bbenchoff/RGB-Gaming-Coaster/README.md

# RGB-Gaming-Coaster
An Oreo construction RGB disc sort of thing

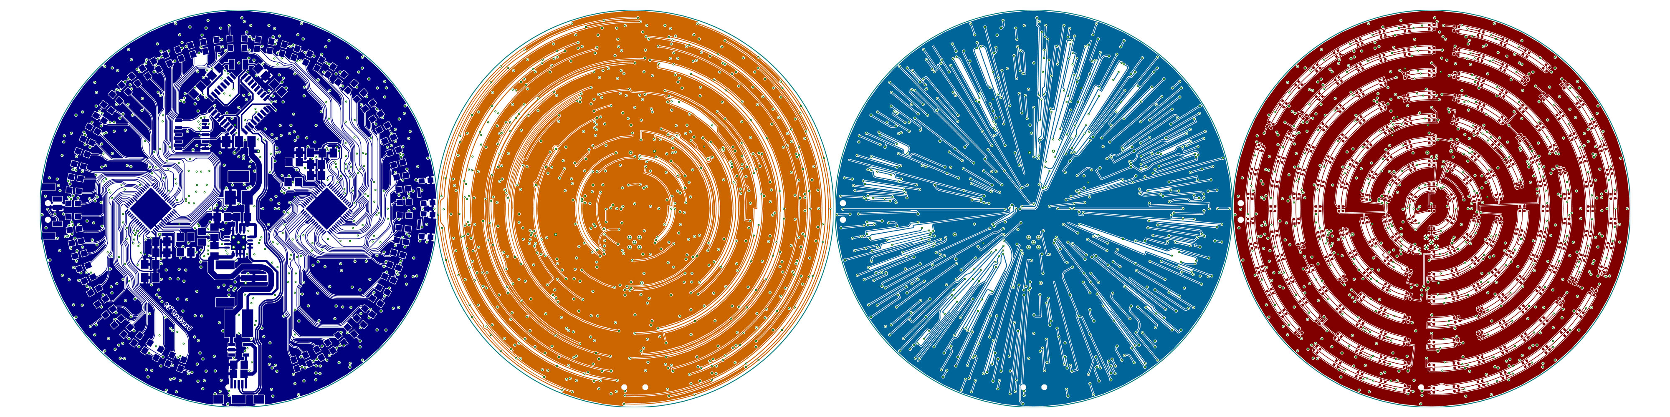
[picture p1: Art/Composite.png]
thing
