bbenchoff/RGB-Gaming-Coaster/Art/1.png

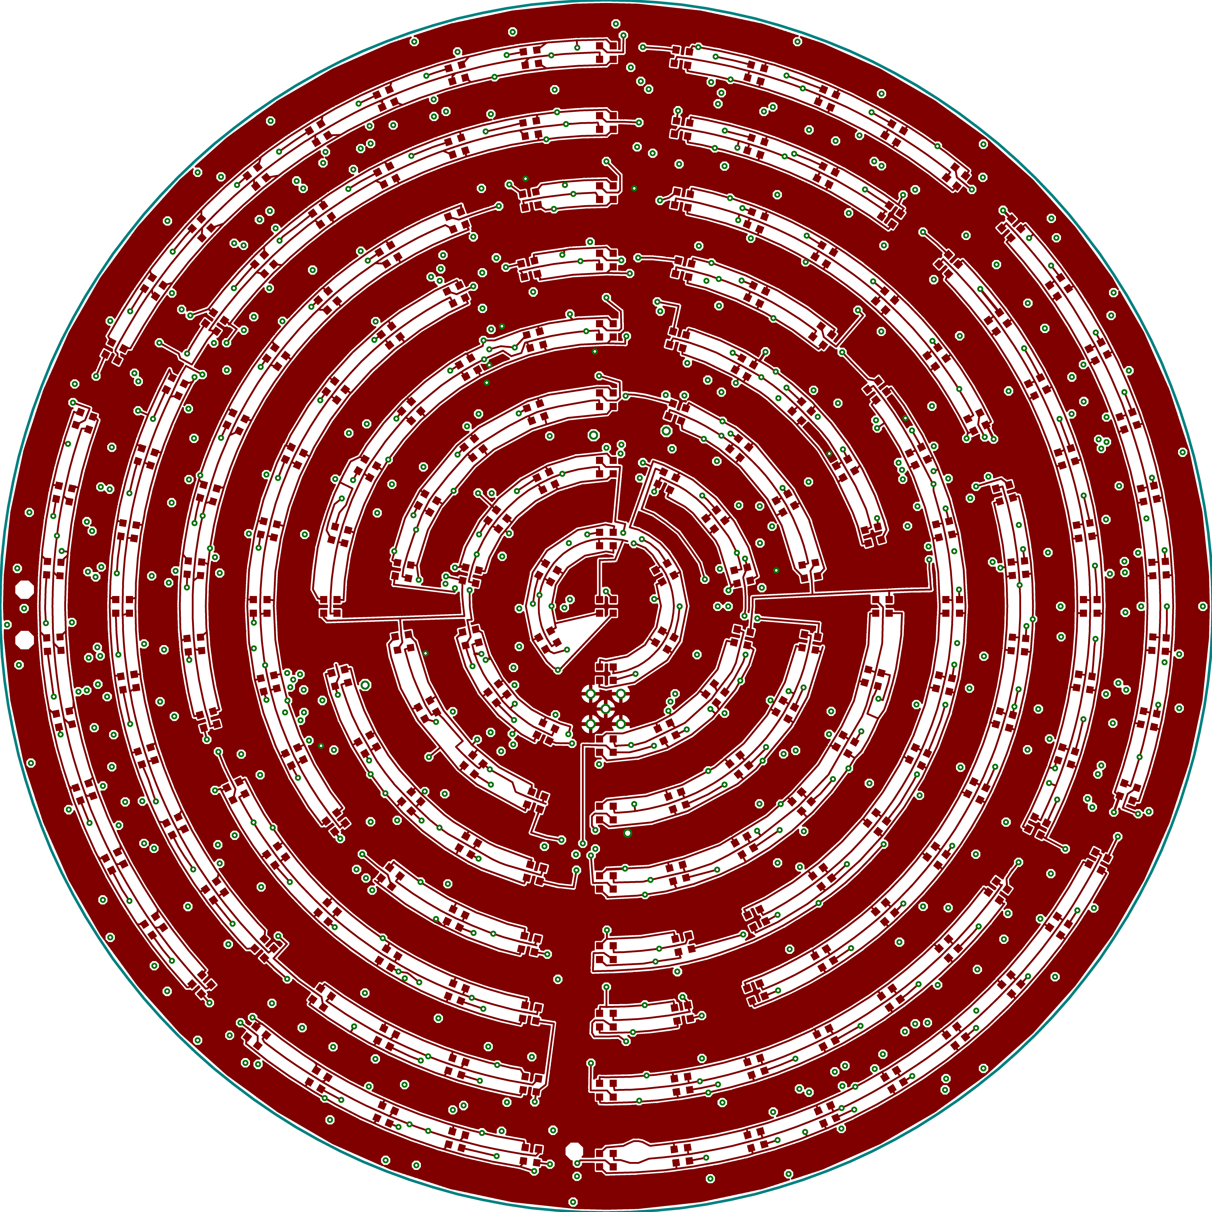
Art/1.png
