bbenchoff/RGB-Gaming-Coaster/Art/2.png

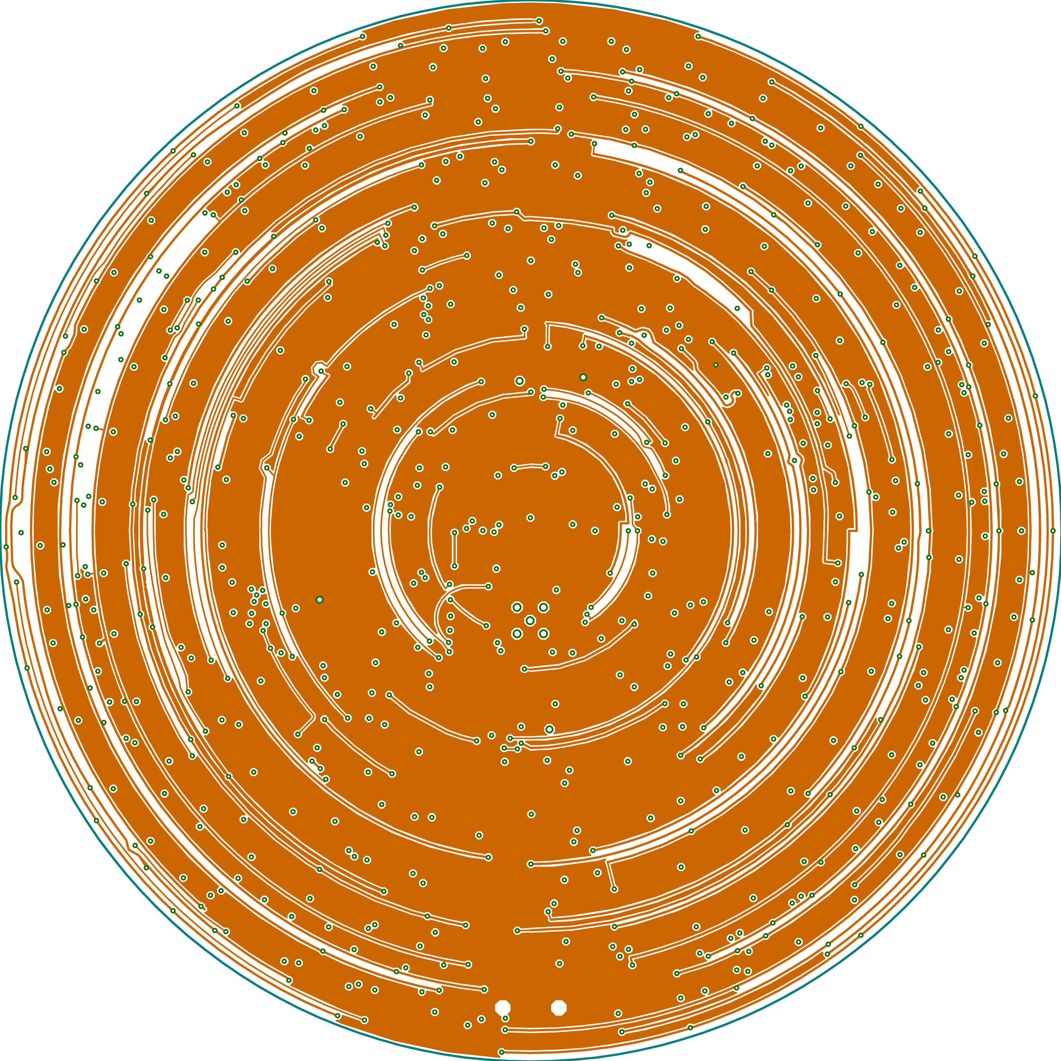
Art/2.png
