bbenchoff/RGB-Gaming-Coaster/Art/15.png

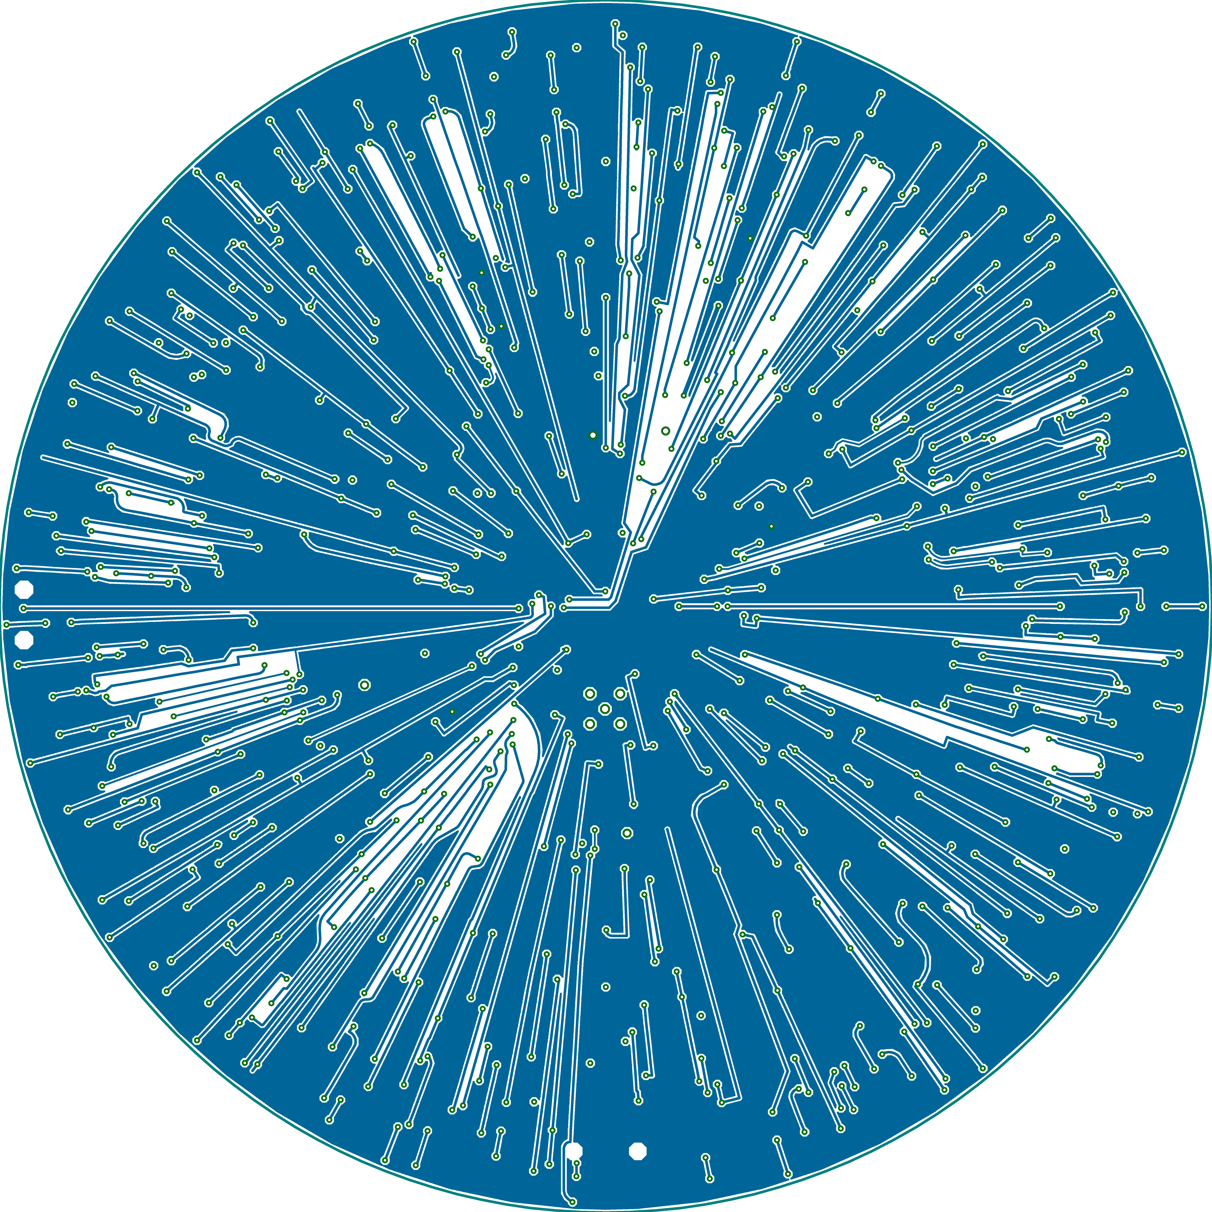
Art/15.png
