bbenchoff/RGB-Gaming-Coaster/Art/16.png

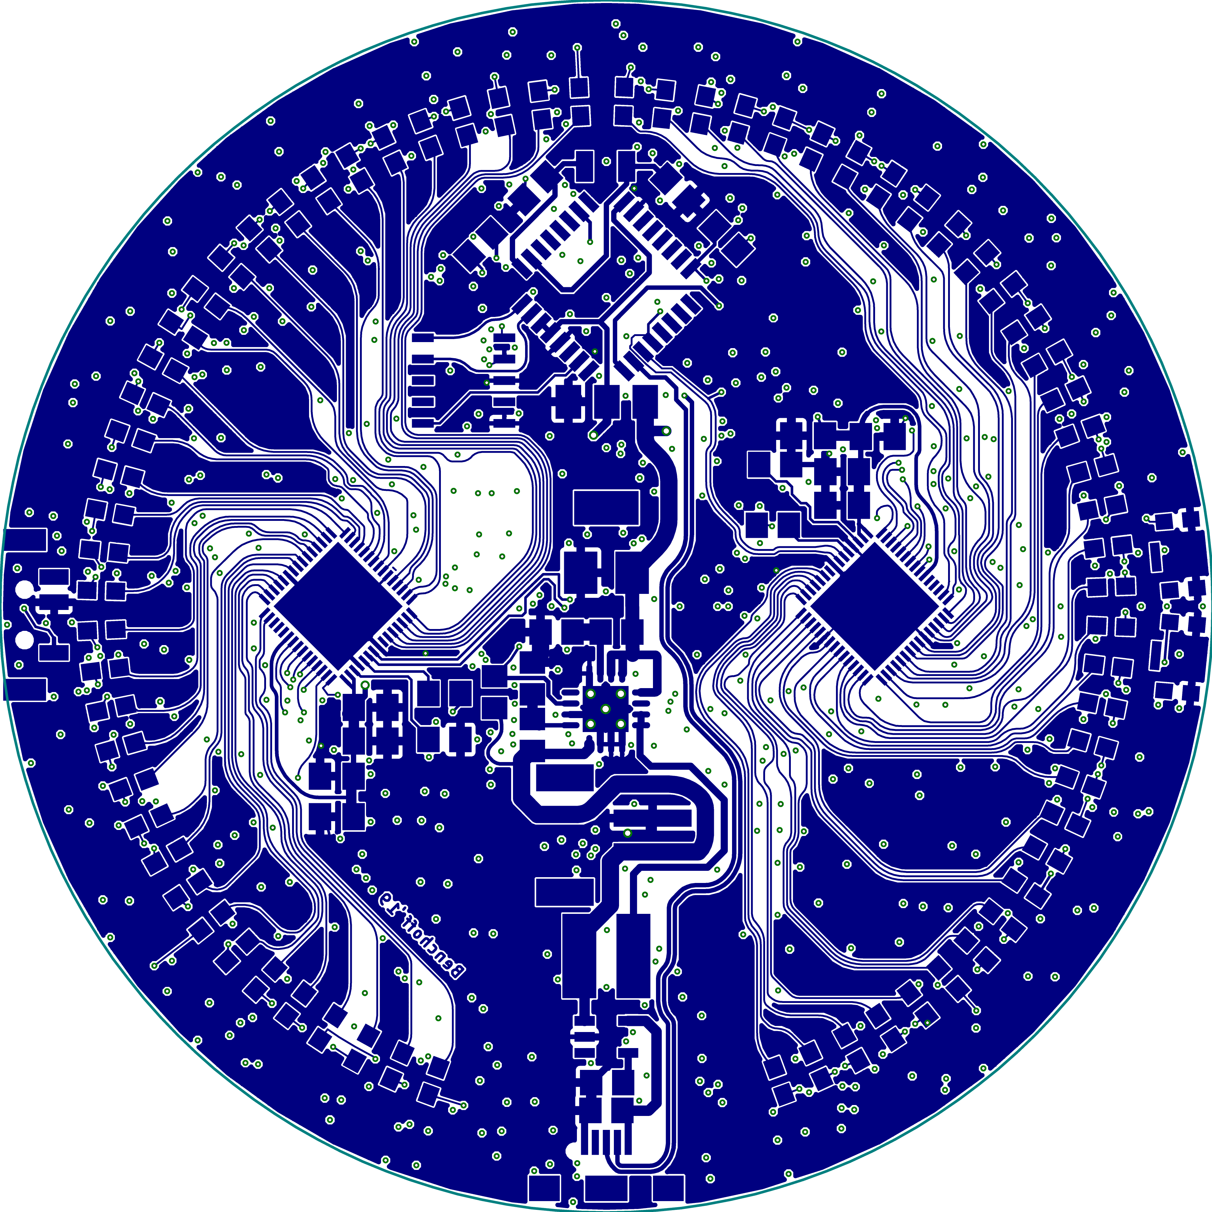
Art/16.png
