bbenchoff/RGB-Gaming-Coaster/Art/Github.bmp

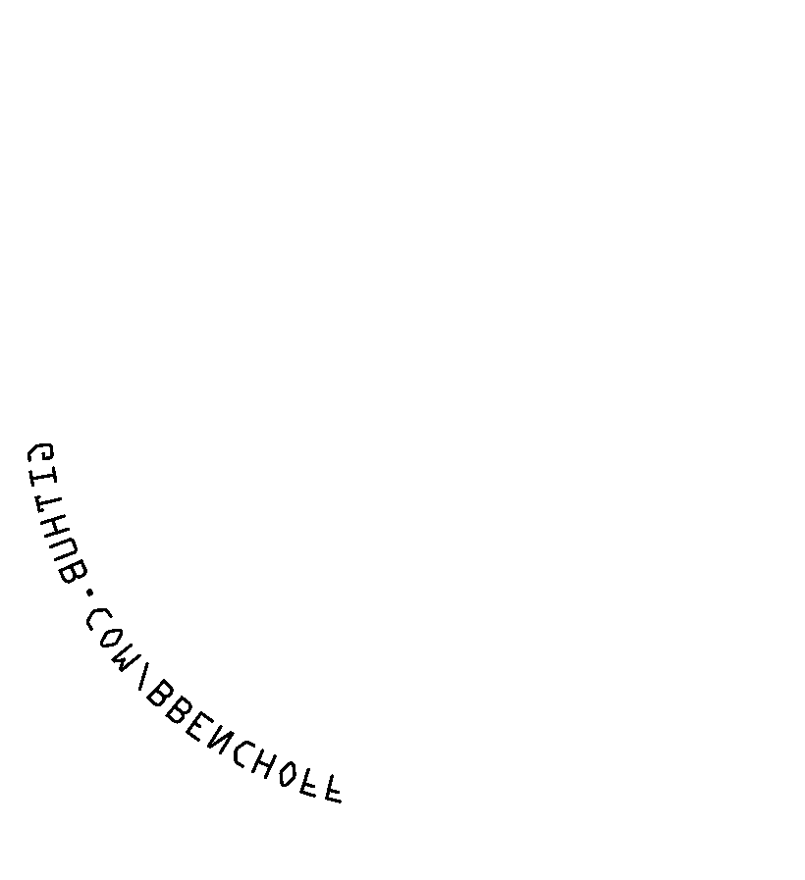
Art/Github.bmp
