bbenchoff/RGB-Gaming-Coaster/Art/Outside Text.bmp

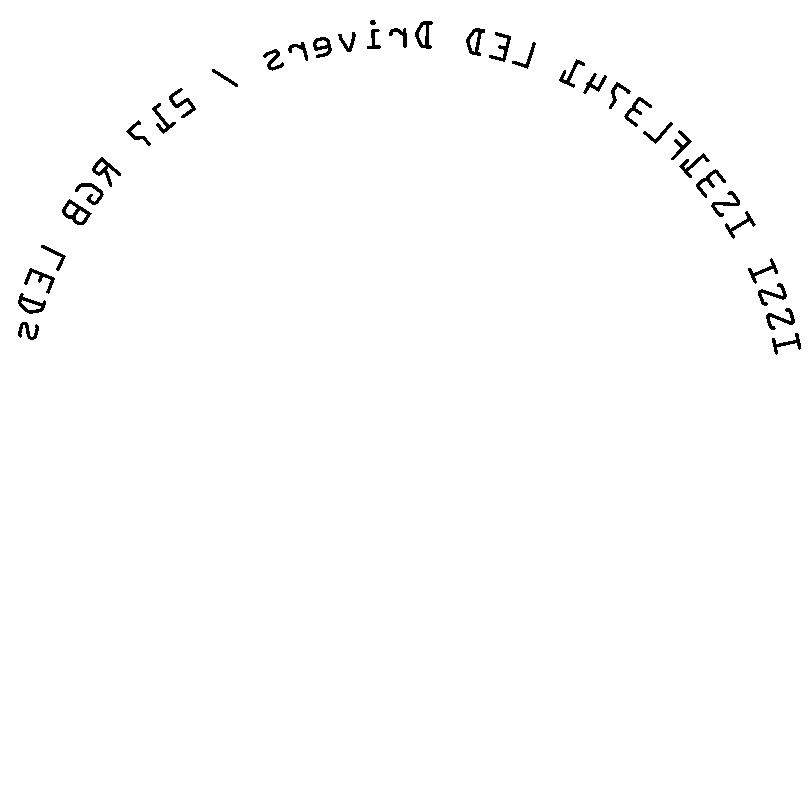
Art/Outside Text.bmp
