bbenchoff/RGB-Gaming-Coaster/Art/RGB Gaming Coaster.bmp

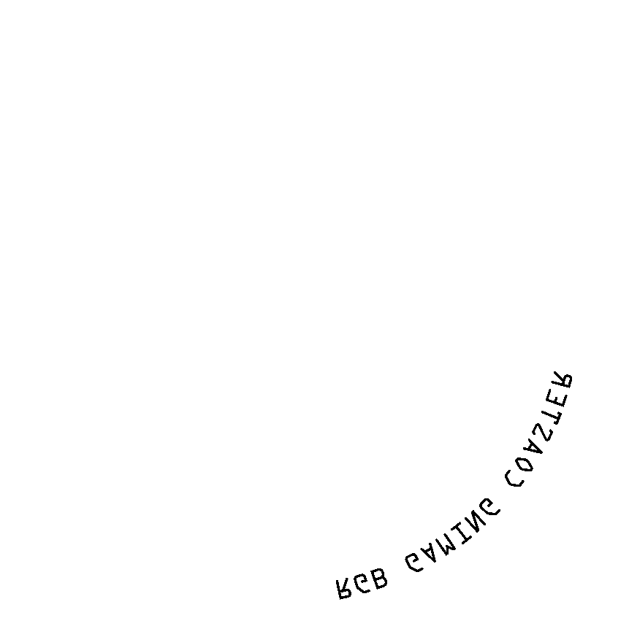
Art/RGB Gaming Coaster.bmp
