bbenchoff/RGB-Gaming-Coaster/Documentation/ring.png

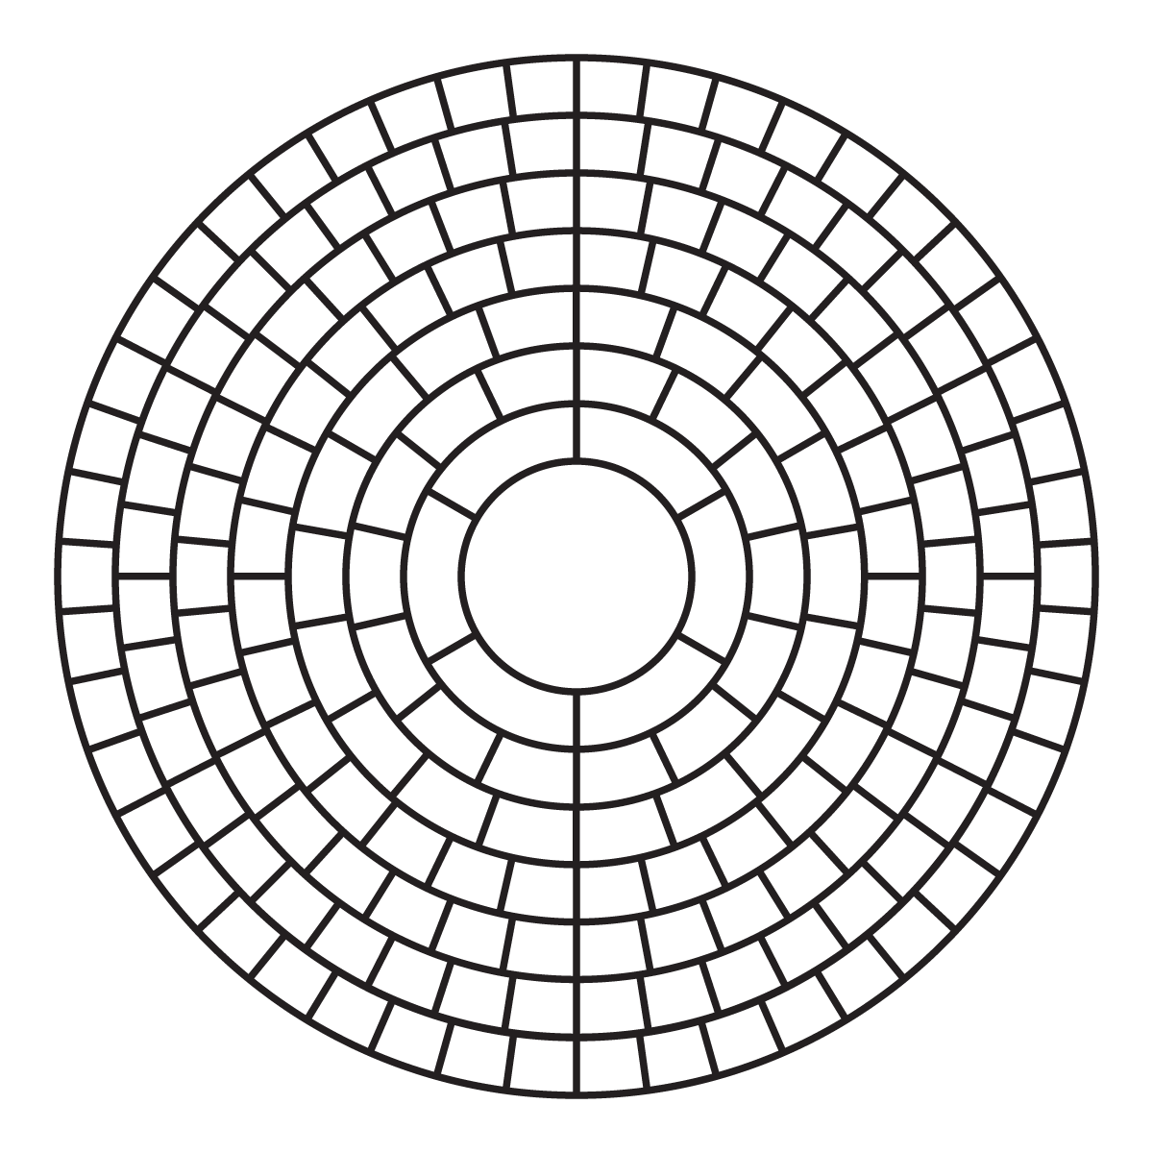
Documentation/ring.png
