bbenchoff/RGB-Gaming-Coaster/Documentation/ringcolors.png

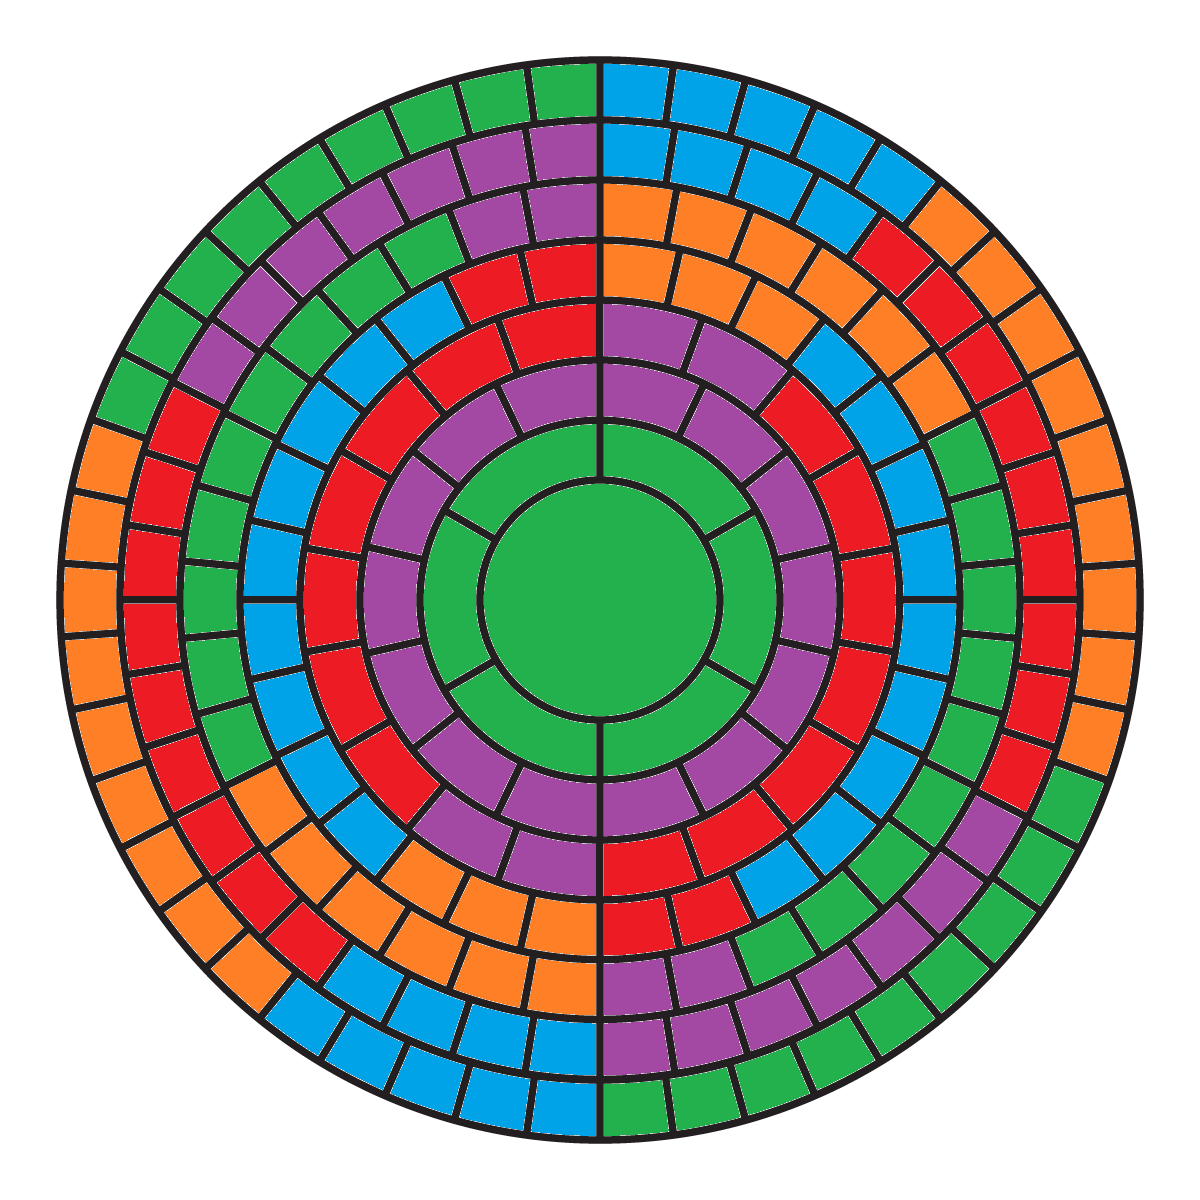
Documentation/ringcolors.png
