bbenchoff/RGB-Gaming-Coaster/LEDboard.png

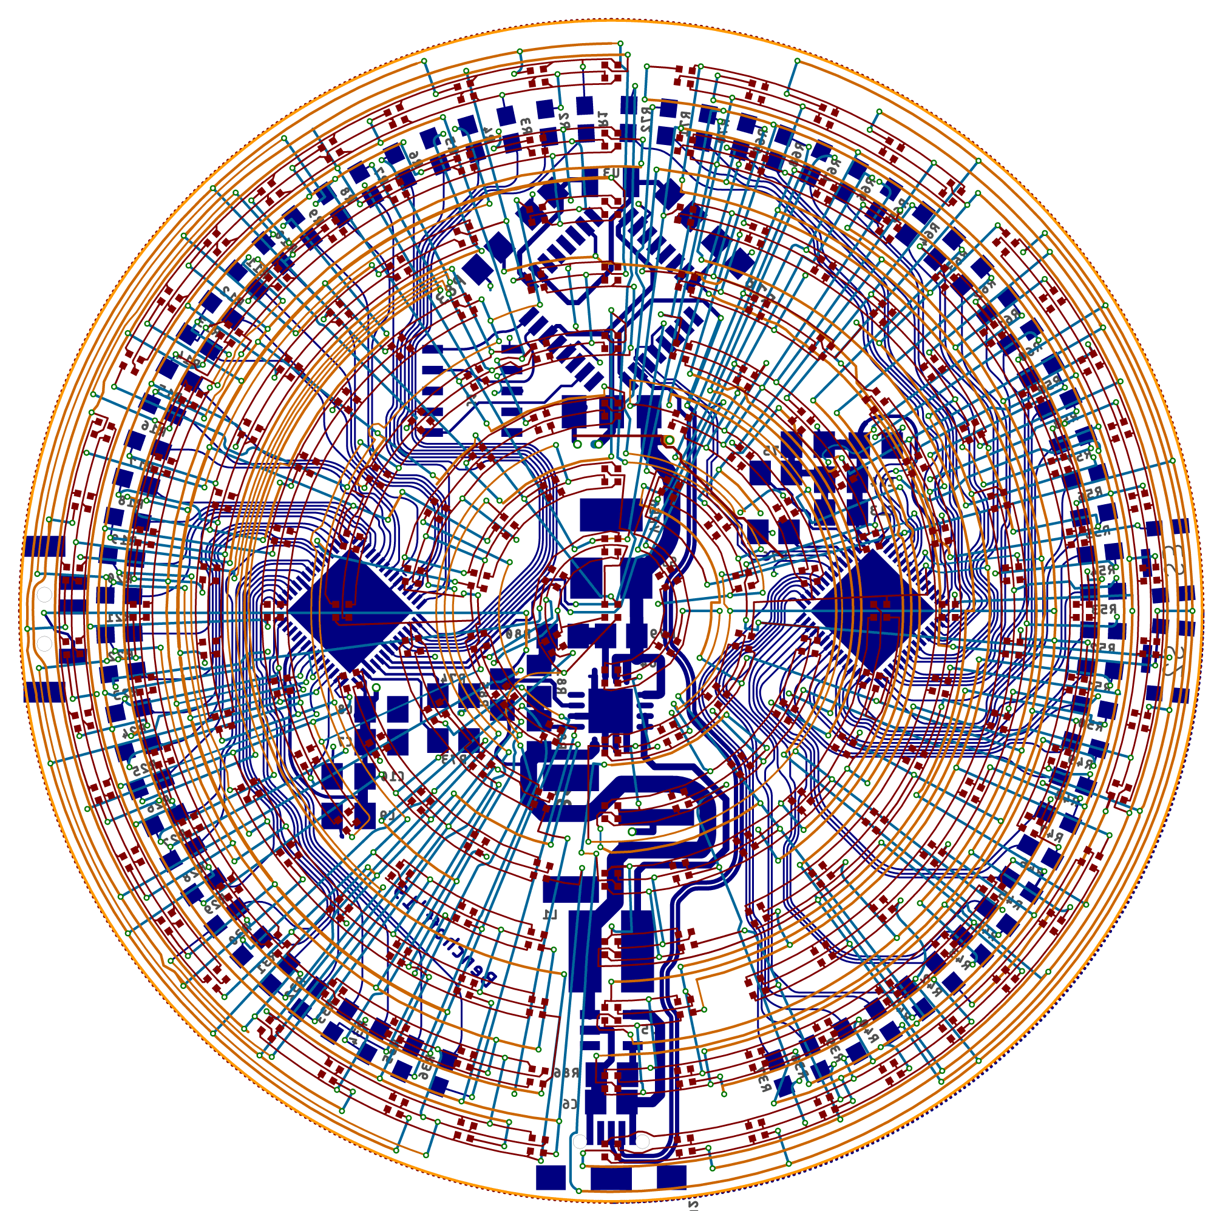
LEDboard.png
