bbenchoff/RGB-Gaming-Coaster/Gerbers/LEDboard.csv

Designator | MPN | QTY | Link | MANUFACTURER_PART_NUMBER | MF | MOUSER_PART_NUMBER | MOUSER_PRICE-STOCK | MPN | OC_FARNELL | OC_NEWARK | PROD_ID | SPICEPREFIX | VALUE
LED1-1-1 | UHD1110-FKA | 1 | https://www.digikey.com/product-detail/en/cree-inc/UHD1110-FKA-CL1A13R3Q1BBQFMF3/UHD1110-FKA-CL1A13R3Q1BBQFMF3CT-ND/9959494
LED1-1-2 | UHD1110-FKA | 1 | https://www.digikey.com/product-detail/en/cree-inc/UHD1110-FKA-CL1A13R3Q1BBQFMF3/UHD1110-FKA-CL1A13R3Q1BBQFMF3CT-ND/9959494
LED1-1-3 | UHD1110-FKA | 1 | https://www.digikey.com/product-detail/en/cree-inc/UHD1110-FKA-CL1A13R3Q1BBQFMF3/UHD1110-FKA-CL1A13R3Q1BBQFMF3CT-ND/9959494
LED1-1-4 | UHD1110-FKA | 1 | https://www.digikey.com/product-detail/en/cree-inc/UHD1110-FKA-CL1A13R3Q1BBQFMF3/UHD1110-FKA-CL1A13R3Q1BBQFMF3CT-ND/9959494
LED1-1-5 | UHD1110-FKA | 1 | https://www.digikey.com/product-detail/en/cree-inc/UHD1110-FKA-CL1A13R3Q1BBQFMF3/UHD1110-FKA-CL1A13R3Q1BBQFMF3CT-ND/9959494
LED1-1-6 | UHD1110-FKA | 1 | https://www.digikey.com/product-detail/en/cree-inc/UHD1110-FKA-CL1A13R3Q1BBQFMF3/UHD1110-FKA-CL1A13R3Q1BBQFMF3CT-ND/9959494
LED1-1-7 | UHD1110-FKA | 1 | https://www.digikey.com/product-detail/en/cree-inc/UHD1110-FKA-CL1A13R3Q1BBQFMF3/UHD1110-FKA-CL1A13R3Q1BBQFMF3CT-ND/9959494
LED1-1-8 | UHD1110-FKA | 1 | https://www.digikey.com/product-detail/en/cree-inc/UHD1110-FKA-CL1A13R3Q1BBQFMF3/UHD1110-FKA-CL1A13R3Q1BBQFMF3CT-ND/9959494
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
R74 | 0805W8F1002T5E | 1 |  |  |  |  |  |  |  |  |  | R
R75 | 0805W8F1002T5E | 1 |  |  |  |  |  |  |  |  |  | R
R76 | 0805W8F1002T5E | 1 |  |  |  |  |  |  |  |  |  | R
R78 | RC0805JR-07200KL | 1
R79 | RC0805FR-071M8L | 1
R80 | RC0805JR-07200KL | 1
R81 | 0805W8F3403T5E | 1
R82 | RC0805FR-071M8L | 1
R83 | RC0805JR-07200KL | 1
R85 | 0805W8F3403T5E | 1
R86 | 0805W8F2001T5E | 1
S2 | KMS221GLFS | 1 | https://www.digikey.com/product-detail/en/c-k/KMS221GLFS/CKN10887TR-ND/2043218 | KMS221GLFS |  | 611-KMS221GLFS | https://www.mouser.com/Search/Refine.aspx?Keyword=611-KMS221GLFS
S3 | KMS221GLFS | 1 | https://www.digikey.com/product-detail/en/c-k/KMS221GLFS/CKN10887TR-ND/2043218 | KMS221GLFS |  | 611-KMS221GLFS | https://www.mouser.com/Search/Refine.aspx?Keyword=611-KMS221GLFS
U$17 | CUS-12TB | 1 | https://www.digikey.com/product-detail/en/nidec-copal-electronics/CUS-12TB/563-1102-1-ND/1124231
U1 | IS31FL3741 | 1 | https://www.digikey.com/product-detail/en/issi-integrated-silicon-solution-inc/IS31FL3741-QFLS4-TR/706-1662-1-ND/9169513
U2 | IS31FL3741 | 1 | https://www.digikey.com/product-detail/en/issi-integrated-silicon-solution-inc/IS31FL3741-QFLS4-TR/706-1662-1-ND/9169513
U3 | ATSAMD21E | 1 | https://www.digikey.com/product-detail/en/microchip-technology/ATSAMD21E18A-AU/ATSAMD21E18A-AU-ND/4935886
U4 | TPS61090RSAR | 1 | https://www.digikey.com/product-detail/en/texas-instruments/TPS61090RSAR/296-15259-1-ND/566899
U5 | MCP73831/2 | 1 | https://www.digikey.com/product-detail/en/microchip-technology/MCP73831-2ACI-MC/MCP73831-2ACI-MC-ND/1874108
VREG | REG1117-3.3/2K5 | 1 | https://www.digikey.com/product-detail/en/texas-instruments/REG1117-3.3-2K5/296-21321-1-ND/1242227 |  |  |  |  | REG1117 | 1097566 | 14P6981
Y1 | FC-135 | 1 |  |  |  |  |  |  |  |  | XTAL-13062 |  | 32.768kHz
B1 | JST 2P-1.0 | 1
C3 | CC0805JRNPO9BN100 | 1 |  |  |  |  |  |  |  |  |  | C
C4 | CC0805JRNPO9BN100 | 1 |  |  |  |  |  |  |  |  |  | C
C5 | T55B107M6R3C0035 | 1
C6 | F920J106MPA | 1 | https://www.digikey.com/product-detail/en/avx-corporation/F920J106MPA/478-8115-1-ND/4005541
C7 | CL21B104KACNNNC | 1 |  |  |  |  |  |  |  |  |  | C
C8 | CC0805ZRY5V8BB105 | 1 |  |  |  |  |  |  |  |  |  | C
C9 | CL21B104KACNNNC | 1 |  |  |  |  |  |  |  |  |  | C
C10 | CC0805ZRY5V8BB105 | 1 |  |  |  |  |  |  |  |  |  | C
C13 | CL21B104KACNNNC | 1 |  |  |  |  |  |  |  |  |  | C
C14 | CC0805ZRY5V8BB105 | 1 |  |  |  |  |  |  |  |  |  | C
C15 | CL21B104KACNNNC | 1 |  |  |  |  |  |  |  |  |  | C
C16 | CC0805ZRY5V8BB105 | 1 |  |  |  |  |  |  |  |  |  | C
J1 | FTSH-105-01 | 1 | https://www.digikey.com/product-detail/en/samtec-inc/FTSH-105-01-F-DV-K-TR/SAM13160CT-ND/8827915
L1 | VLS5045EX-6R8M | 1 | https://www.digikey.com/product-detail/en/tdk-corporation/VLS5045EX-6R8M/445-174855-1-ND/6560412
