bbenchoff/RGB-Gaming-Coaster/DXFs/MoreRadials.dxf

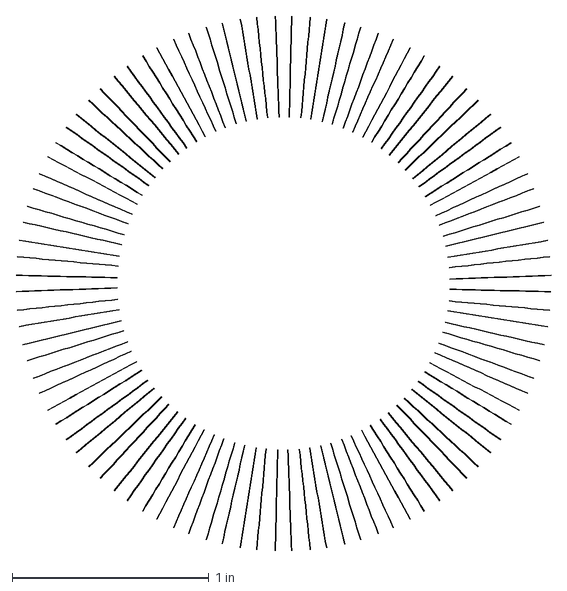
[picture p12: CAD file, 2019-08-28]
DXFs/MoreRadials.dxf
2.72 x 2.72 in
