bbenchoff/RGB-Gaming-Coaster/DXFs/RadialLines.dxf

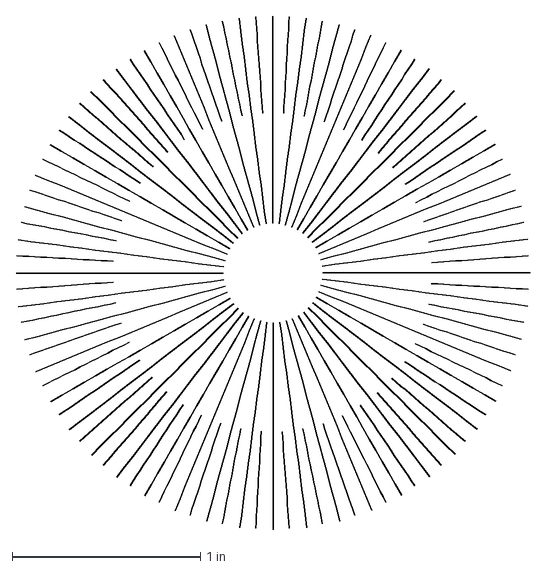
[picture p13: CAD file, 2019-08-28]
DXFs/RadialLines.dxf
2.73 x 2.73 in
