bbenchoff/RGB-Gaming-Coaster/DXFs/CrossRadials.dxf

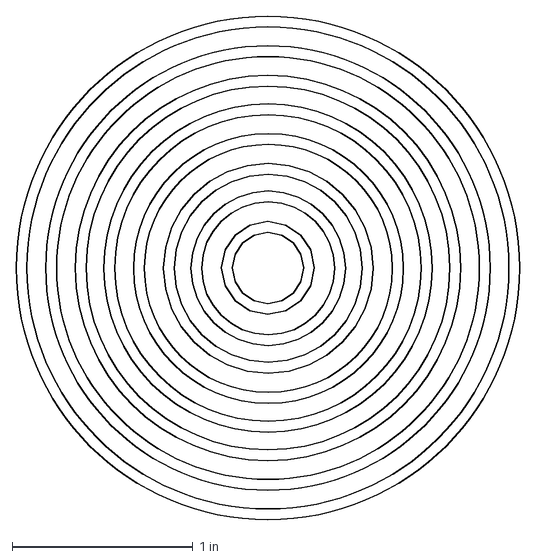
[picture p14: CAD file, 2019-08-28]
DXFs/CrossRadials.dxf
2.79 x 2.79 in
