bbenchoff/RGB-Gaming-Coaster/DXFs/TopSurrounds.dxf

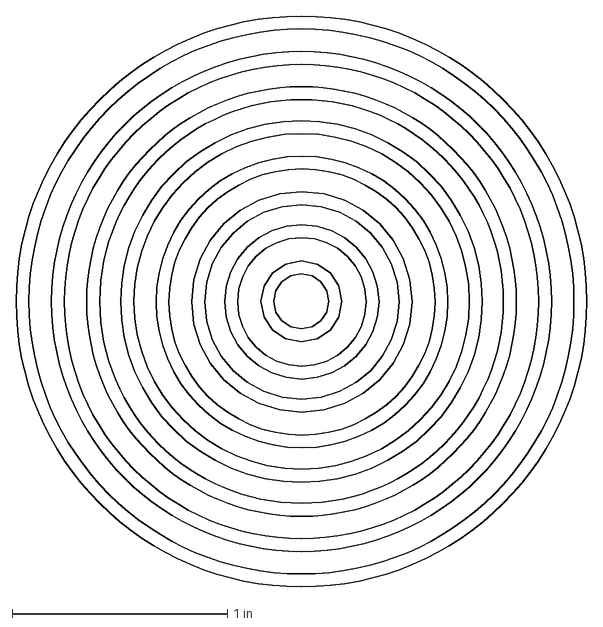
[picture p15: CAD file, 2019-08-28]
DXFs/TopSurrounds.dxf
2.65 x 2.65 in
