bbenchoff/RGB-Gaming-Coaster/DXFs/BetweenLEDs.dxf

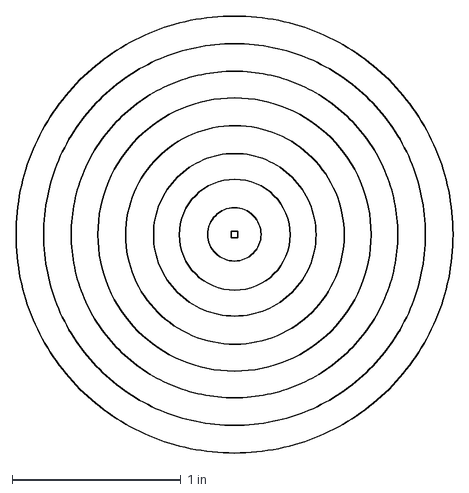
[picture p16: CAD file, 2019-08-28]
DXFs/BetweenLEDs.dxf
2.59 x 2.59 in
