bbenchoff/RGB-Gaming-Coaster/LEDboard.pdf

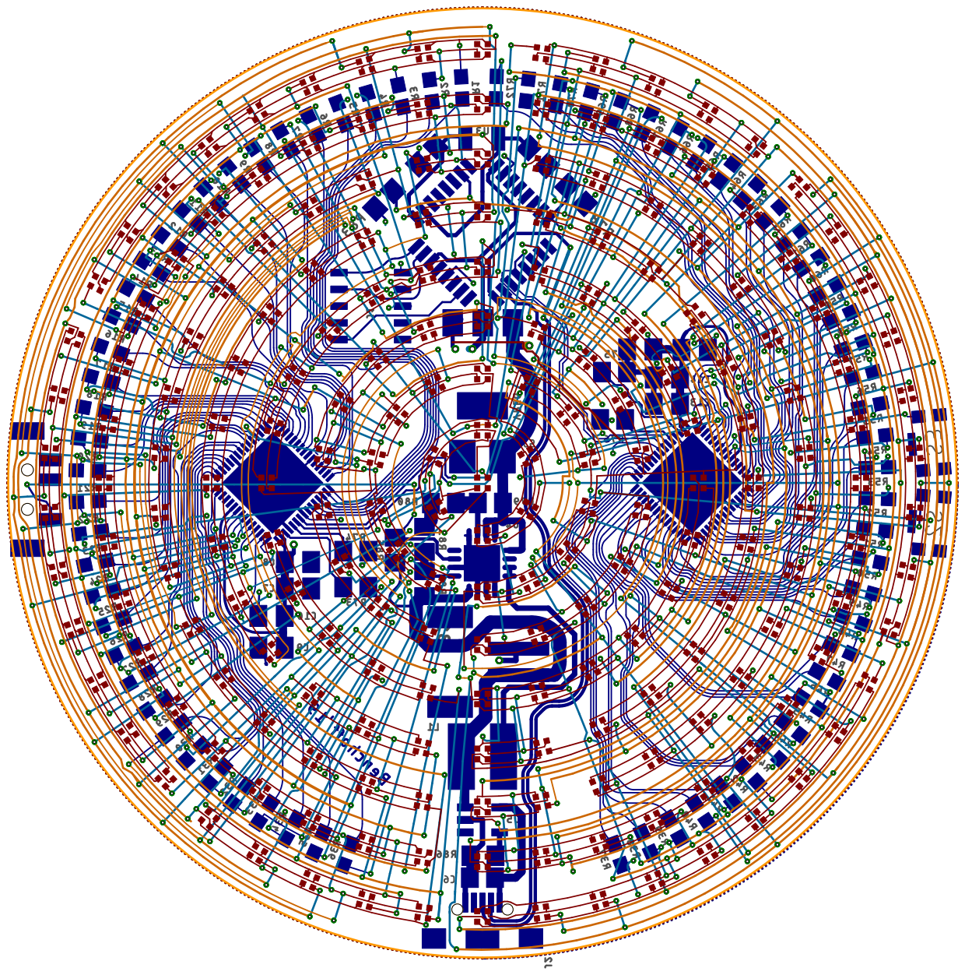
[picture p17: page 1]
