bbenchoff/RGB-Gaming-Coaster/Art/Finalized.pdf

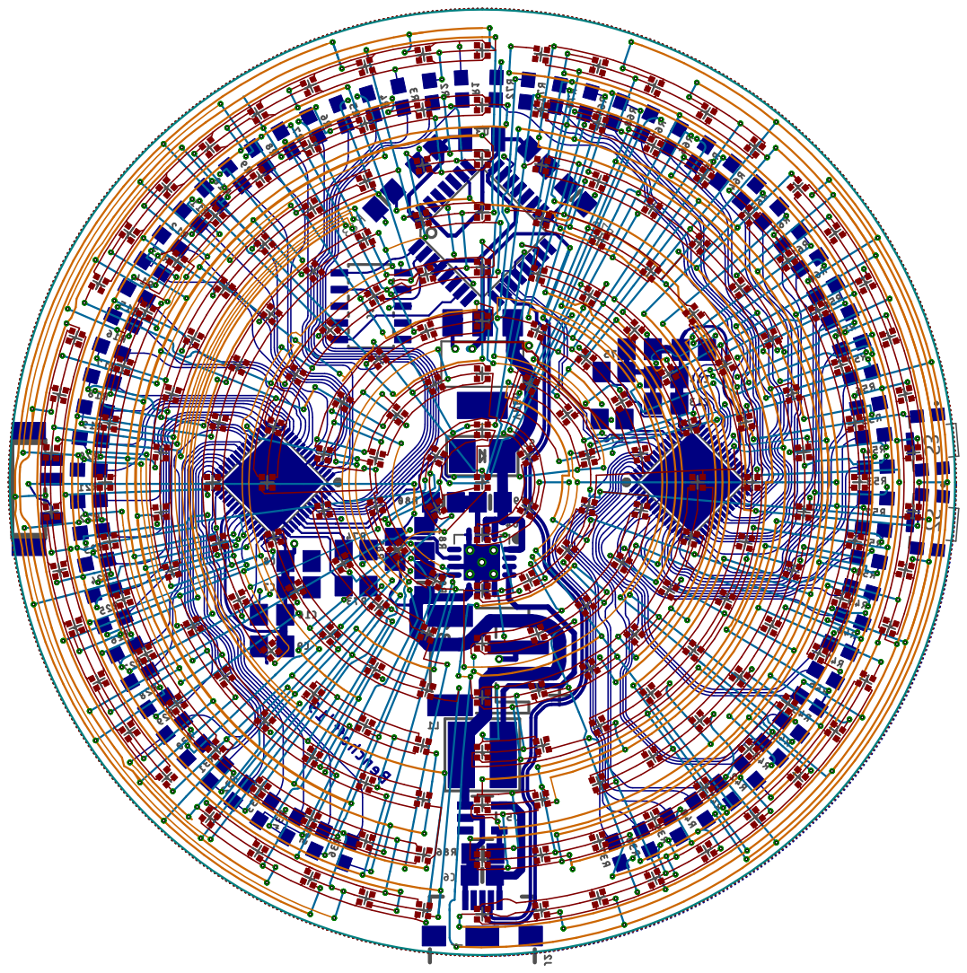
[picture p18: page 1]
