bbenchoff/RGB-Gaming-Coaster/Art/FullNotFilled.pdf

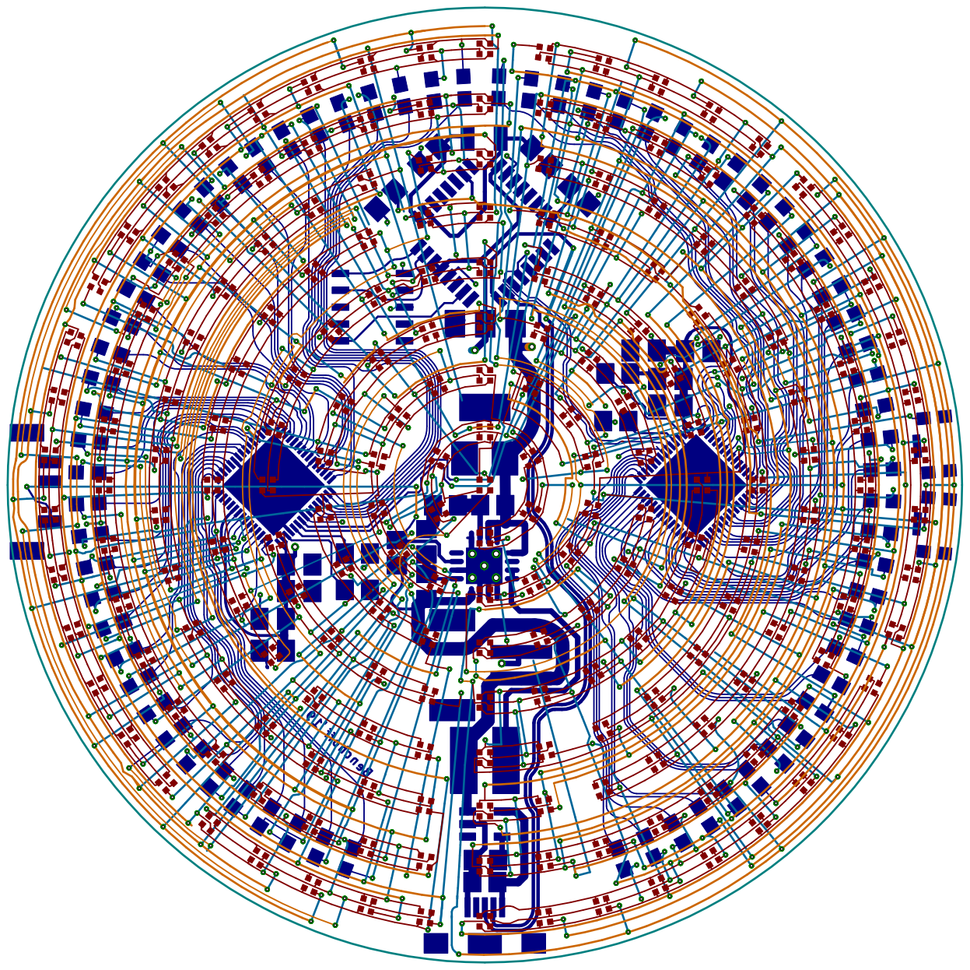
[picture p19: page 1]
