bbenchoff/RGB-Gaming-Coaster/(commit log)

2019-07-22 Initial
    Just the spacer plate
    [HolePlate.brd]
2019-07-23 Placed LEDs
    [LEDboard.brd, LEDboard.sch]
2019-07-26 Half routing
    [DRILEGEND.CFG, LEDboard.brd, LEDboard.sch]
2019-07-27 Placed Everything
    [LEDboard.brd, LEDboard.sch]
2019-07-29 Added more stuff
    [LEDboard.brd, LEDboard.sch]
2019-07-30 placed power
    [LEDboard.brd, LEDboard.sch]
2019-07-30 dear fucking god
    [LEDboard.brd, LEDboard.sch]
2019-07-31 Remove LBO, change bypass cap
    [LEDboard.brd, LEDboard.sch]
2019-07-31 holy shit one layer
    [LEDboard.brd, LEDboard.sch]
2019-08-02 diff pair
    [LEDboard.brd, LEDboard.sch]
2019-08-04 all parts placed?
    [LEDboard.brd, LEDboard.sch]
2019-08-05 Added jtag, power
    [LEDboard.brd, LEDboard.sch]
2019-08-05 rotate
    did something
    [LEDboard.brd, LEDboard.sch]
2019-08-05 Added jumper 0ohm resistor
    [LEDboard.brd, LEDboard.sch]
2019-08-06 Ground fill / button
    [LEDboard.brd, LEDboard.sch]
2019-08-06 I think I fucked something up
    [LEDboard.brd, LEDboard.sch]
2019-08-07 I need a record of me fucking up
    lol move all the resistors
    [LEDboard.brd]
2019-08-07 fixed the leds
    [LEDboard.brd]
2019-08-25 dear god
    [LEDboard.brd]
2019-08-25 jesus hell
    [LEDboard.brd]
2019-08-25 Mother of god
    [LEDboard.brd, LEDboard.sch]
2019-08-27 It's half done
    [LEDboard.brd]
2019-08-28 Massive rewrite
    [BetweenLEDs.dxf, CrossRadials.dxf, LEDboard.brd, RadialLines.dxf, TopSurrounds.dxf]
2019-08-28 added more radial guide lines
    [LEDboard.brd, MoreRadials.dxf]
2019-08-30 fuckin around
    [LEDboard.brd]
2019-09-02 Stage 1 done
    [LEDboard.brd]
2019-09-06 another ring
    [LEDboard.brd]
2019-09-06 another row
    [LEDboard.brd]
2019-09-07 begin removal
    [LEDboard.brd]
2019-09-08 more rows
    [LEDboard.brd]
2019-09-09 another bunch
    [LEDboard.brd]
2019-09-09 finished left hand
    [LEDboard.brd]
2019-09-10 omg jesus christ
    [LEDboard.brd]
2019-09-10 Beginning the final routing
    [LEDboard.brd]
2019-09-10 one side done
    [LEDboard.brd]
2019-09-10 jesus fuck me it's done
    [LEDboard.brd]
2019-09-16 getting rid of airwires
    [LEDboard.brd]
2019-09-16 24 left
    [LEDboard.brd]
2019-09-17 dear jesus it's done
    [LEDboard.brd]
2019-09-17 Fixed address pins
    [LEDboard.brd, LEDboard.sch]
2019-09-18 Start work on assembly
    [LEDboard.GBL, LEDboard.GBO, LEDboard.GBP, LEDboard.GBS, LEDboard.GTL, LEDboard.GTO, LEDboard.GTP, LEDboard.GTS]
2019-09-18 updated bom
    [LEDboard.csv]
2019-09-19 fidex stuff
    [LEDboard.GBL, LEDboard.GBO, LEDboard.GBP, LEDboard.GBS, LEDboard.GTL, LEDboard.GTO, LEDboard.GTP, LEDboard.GTS]
2019-09-19 added for pack plate
2019-09-21 Made back plate
    [BackPlate.brd]
2019-09-21 Updated plates
    [BackPlate.brd, CoverPlate.brd, LEDboard.brd]
2020-04-12 Fixed tiny issue, now works
    [LEDboard.brd, LEDboard.sch]
2020-04-14 updated board
    [LEDboard.brd]
2021-02-24 Added circuit Diagram
